damienmaguire/Tesla-Gen3-Charger/Pinout_V1.jpg

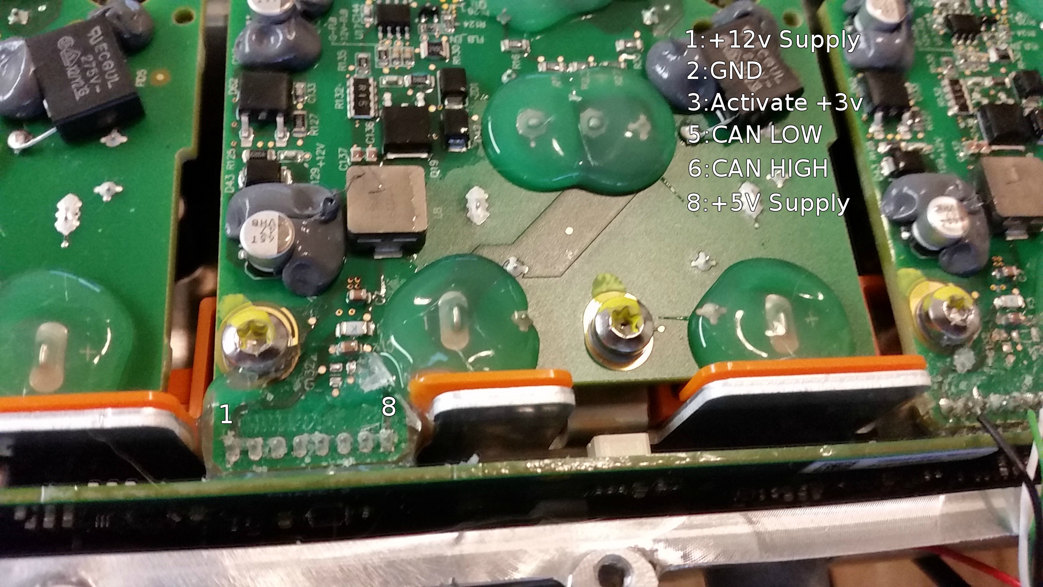
Pinout_V1.jpg
