damienmaguire/Tesla-Gen3-Charger/V3/Charger_Gen3_V3_BOM_JLC.xls

Comment | Designator | Package | LCSC Part #
1N4148WS | D1,D2,D3,D8,D9 | SOD-323F | C2128
8MHz | Y1 | SMD-5032_2P | C112659
AMS117-3.3V | IC1 |  | C6186
0.1uF | C22,C15,C19,C14,C11,C12,C10,C16,C4 | 0805_C | C49678
1uF | C3,C2,C17,C20,C7 | 0805_C | C28323
10uF | C1,C13,C23 | 0805_C | C15850
27pF | C5,C18 | 0805_C | C1804
LED0805 | LED1,LED2 | LED_0805 | C84256
MMBT3904 | TR1 | SOT-23-3 | C20526
NCV8402ASTT1G | IC6,IC7 | SOT-223 | C77755
0Ω | R12 | 0805_R | C17477
1KΩ | R7 | 0805_R | C17513
1.3KΩ | R8 | 0805_R | C17384
1.5KΩ | R5,R2 | 0805_R | C4310
1.8KΩ | R28 | 0805_R | C17398
2.7KΩ | R9 | 0805_R | C17530
4.7KΩ | R1,R4 | 0805_R | C17673
8.2KΩ | R27 | 0805_R | C17828
10KΩ | R14,R15,R24,R25 | 0805_R | C17414
22KΩ | R6 | 0805_R | C17560
100KΩ | R10,R17 | 0805_R | C17407
120Ω | R18 | 0805_R | C17437
330Ω | R13 | 0805_R | C17630
680Ω | R3,R16,R11 | 0805_R | C17798
SN65HVD230DR | IC5 | SOIC-8_3.9x4.9x1.27P | C12084
74HCT125D | IC3 | SOIC-14_3.9x8.7x1.27P | C5962
SS54 | D4,D5 | SMA,DO-214AC | C22452
STM32F103C8T6TR | IC2 | LQFP-48_7.0x7.0x0.5P | C8734
68uH | L2 | SMD-PIND-12.5x12.5x8_2.9x5.4 | C169377
100UF 6.3V | C6,C9,C8 | CASE-B_3528 | C16133
470uF 25V | C21 | SMD-ECAP-10x10 | C249931
10uH | L1 |  | C1046
XL1509-5.0E1 | IC4 | SOP-8_3.9x4.9x1.27P | C61063
