damienmaguire/Tesla-Gen3-Charger/Charger_Gen3_V1 - Schematic.pdf

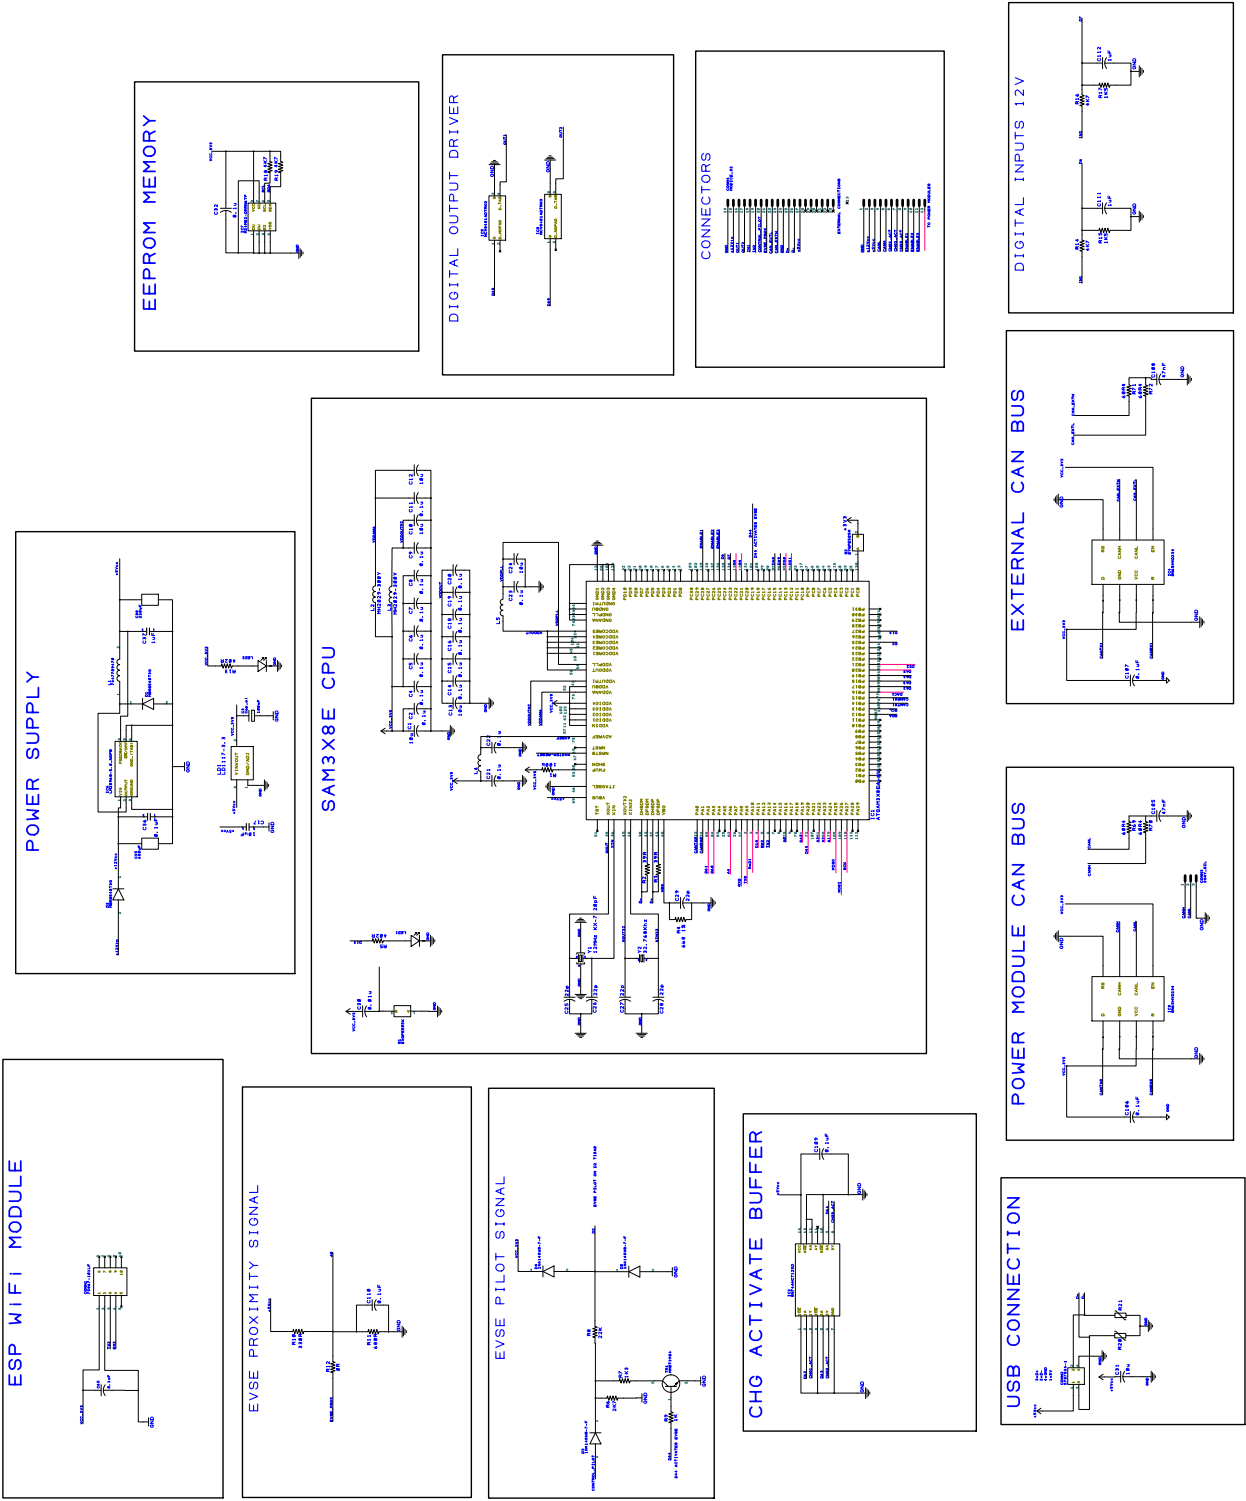
[picture p2: page 1]
