damienmaguire/Tesla-Gen3-Charger/V3/Charger_Gen3_V3 - Schematic.pdf

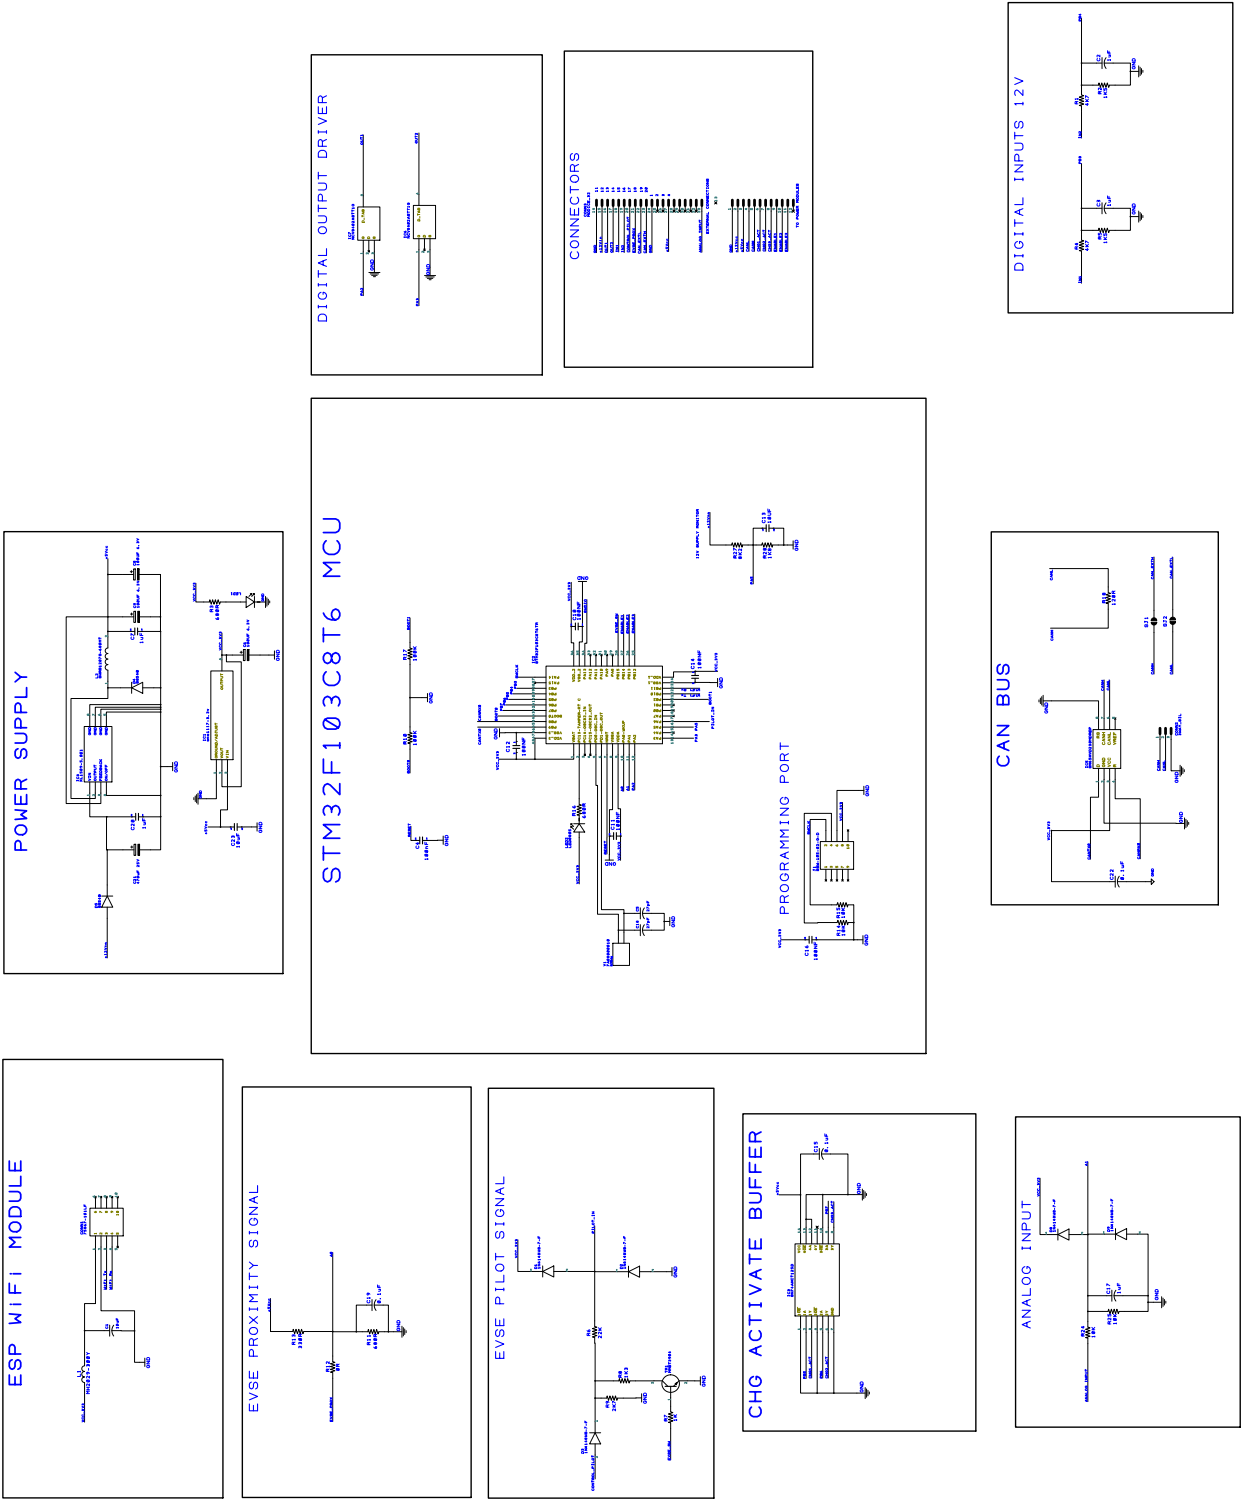
[picture p3: page 1]
