damienmaguire/Tesla-Gen3-Charger/Charger_Gen3_V1 - PCB.pdf

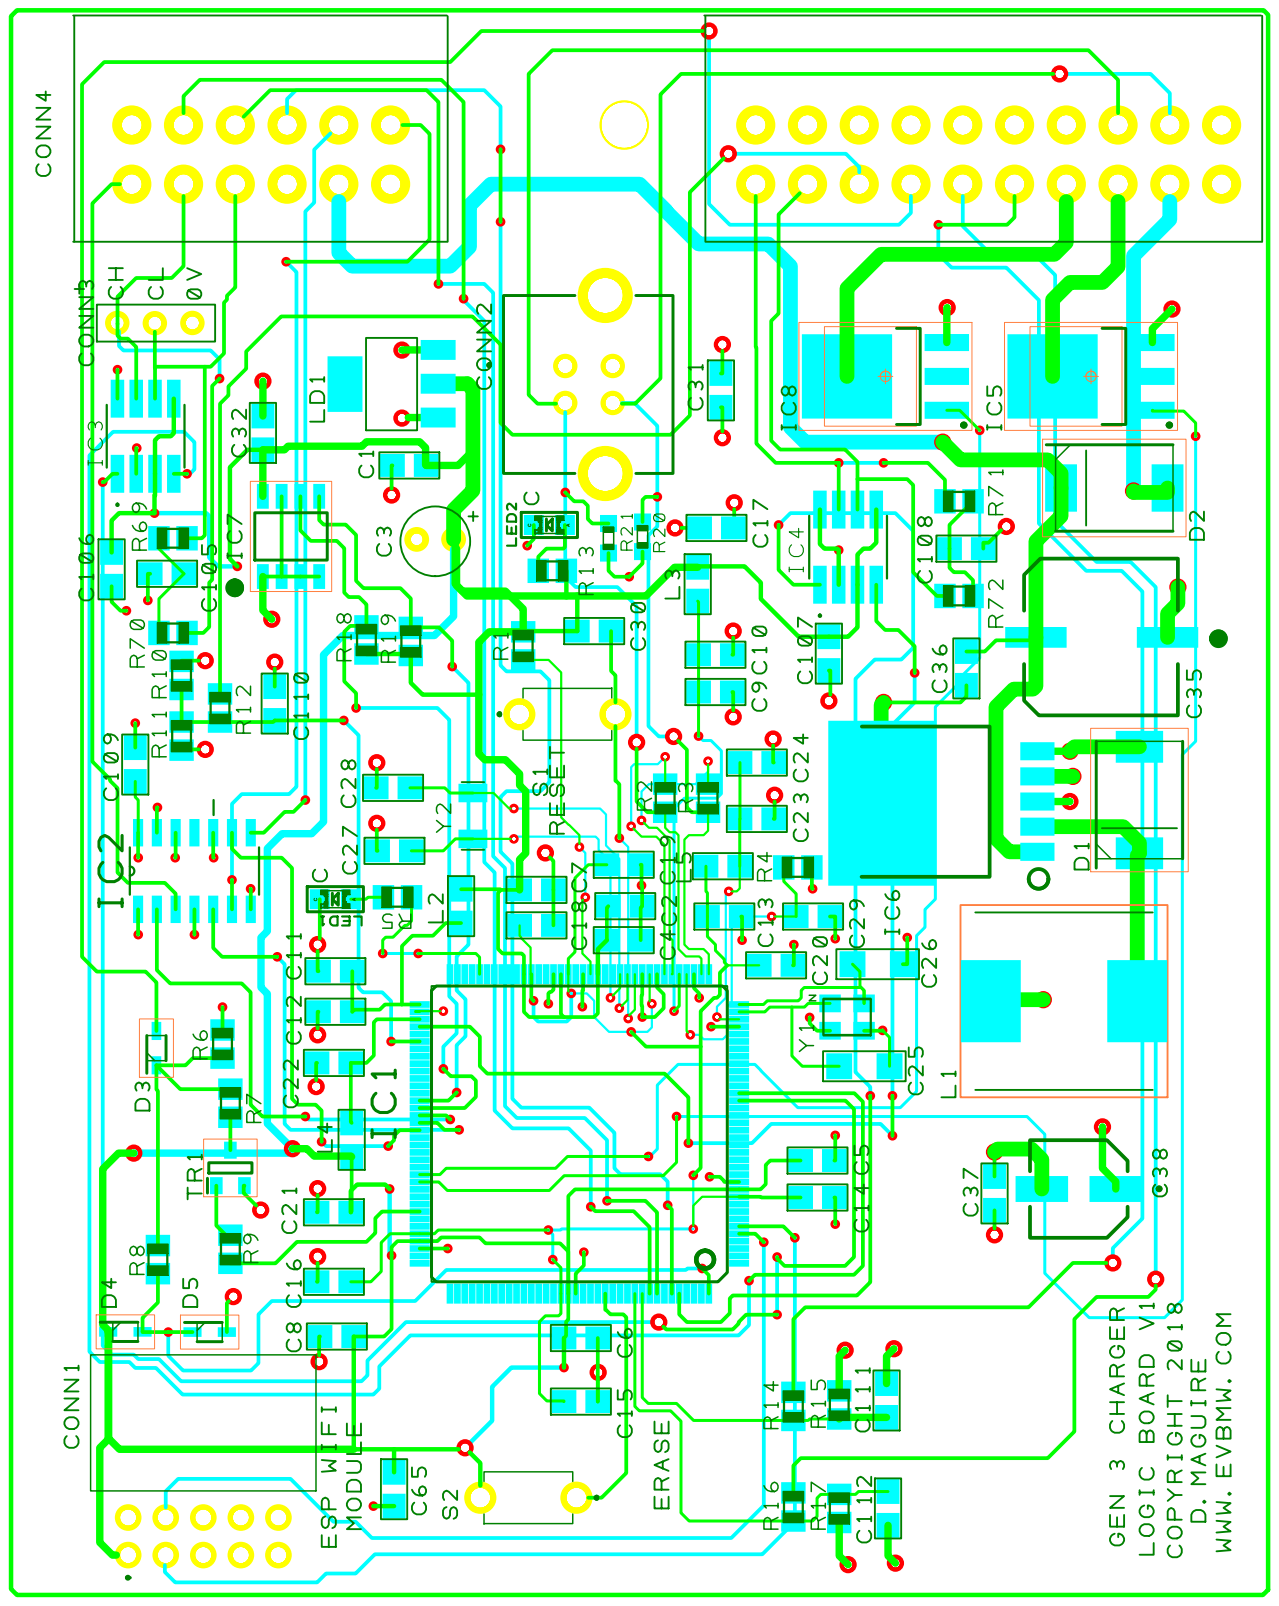
[picture p4: page 1]
