damienmaguire/Tesla-Gen3-Charger/V3/Charger_Gen3_V3 - PCB.pdf

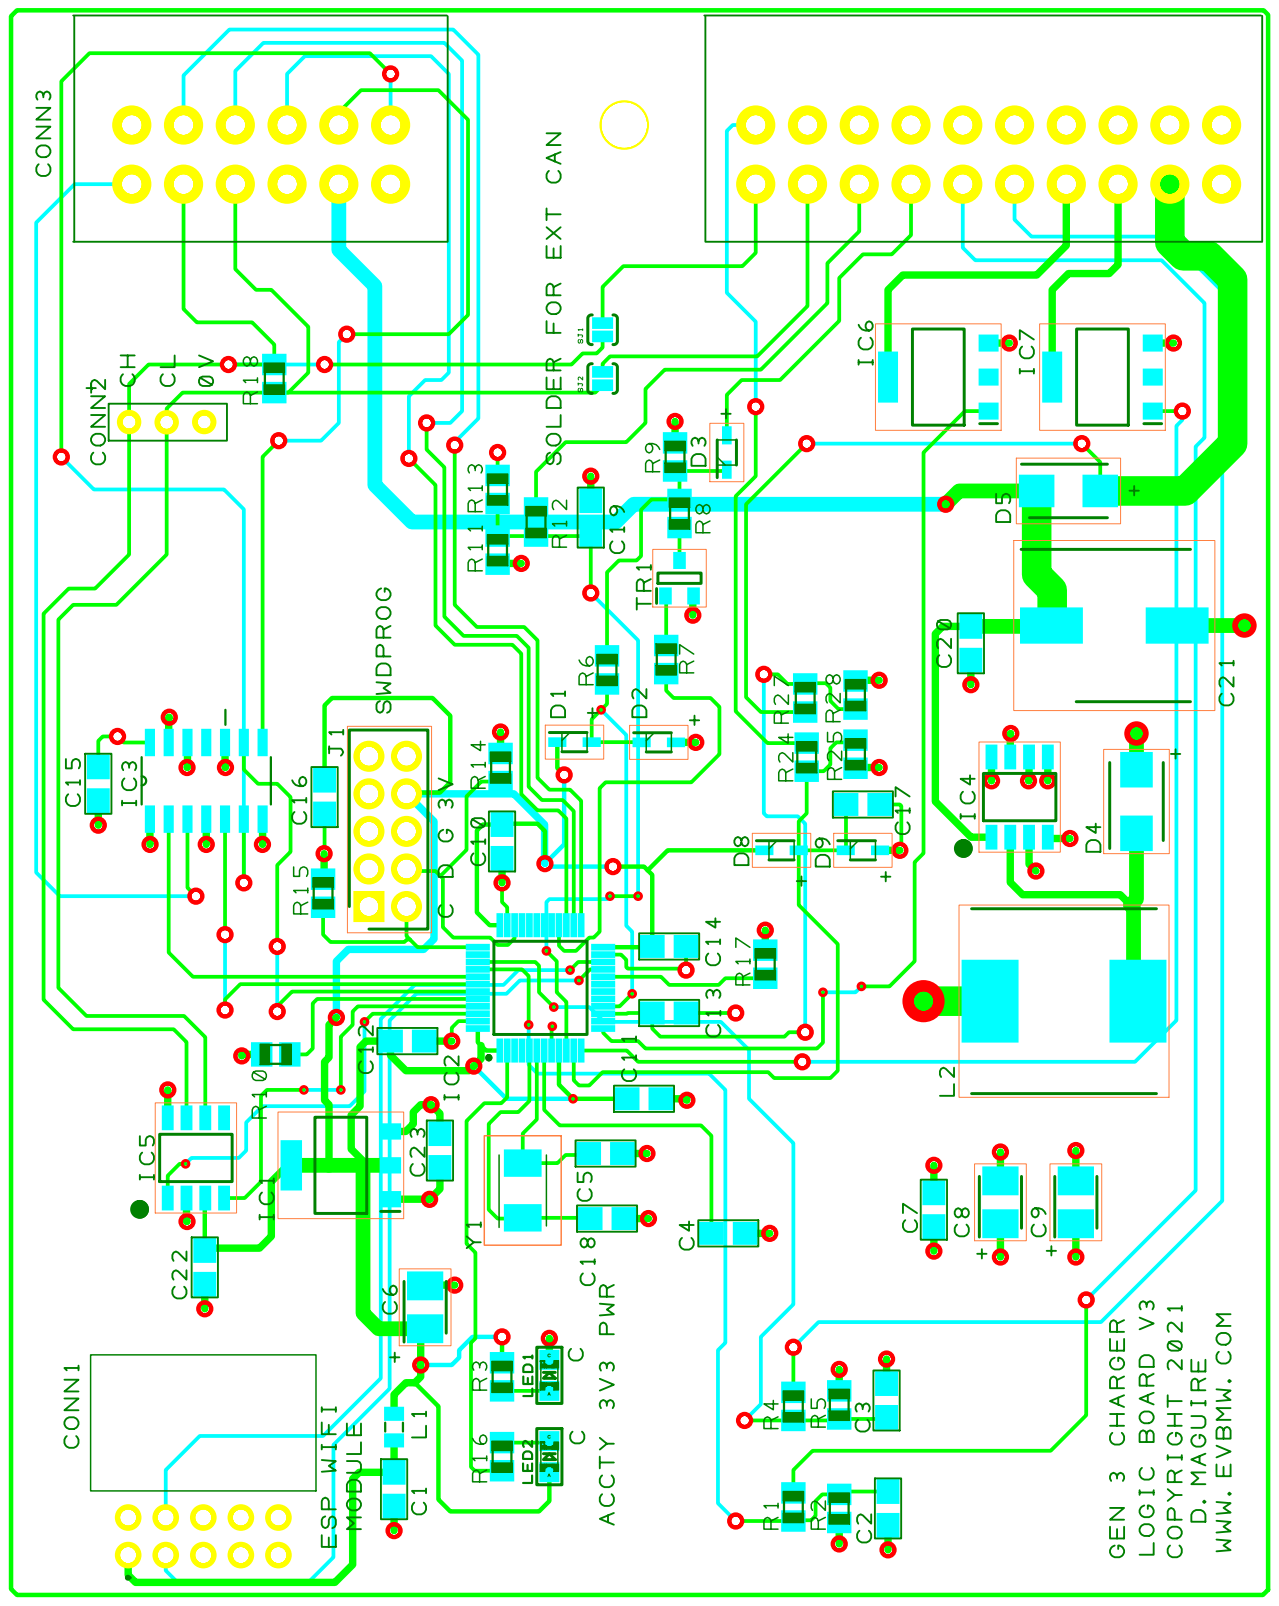
[picture p5: page 1]
