damienmaguire/Tesla-Gen3-Charger/(list of files, drawings)

Other design files:
Charger_Gen3_V1.pcb
V3/Charger_Gen3_V3.pcb
