damienmaguire/Tesla-Gen3-Charger/(commit log)

2020-02-29 Allow GH to format the CSV.
    [Full_dump1_logic_ph123_12v_applied.csv]
2021-11-01 fixed typo on BOM; C24 should be R24
    [Charger_Gen3_V3_BOM_JLC.xls]
